htfab/flash-adc/verilog/gl/encoder.v

module encoder (VGND,
    VPWR,
    from_adc,
    ui_in,
    uio_in,
    uio_oe,
    uio_out,
    uo_out);
 input VGND;
 input VPWR;
 input [14:0] from_adc;
 input [7:0] ui_in;
 input [7:0] uio_in;
 output [7:0] uio_oe;
 output [7:0] uio_out;
 output [7:0] uo_out;

 wire _000_;
 wire _001_;
 wire _002_;
 wire _003_;
 wire _004_;
 wire _005_;
 wire _006_;
 wire _007_;
 wire _008_;
 wire _009_;
 wire _010_;
 wire _011_;
 wire _012_;
 wire _013_;
 wire _014_;
 wire _015_;
 wire _016_;
 wire _017_;
 wire _018_;
 wire _019_;
 wire _020_;
 wire _021_;
 wire _022_;
 wire _023_;
 wire _024_;
 wire _025_;
 wire _026_;
 wire _027_;
 wire _028_;
 wire _029_;
 wire _030_;
 wire _031_;
 wire _032_;
 wire _033_;
 wire _034_;
 wire _035_;
 wire _036_;
 wire _037_;
 wire _038_;
 wire _039_;
 wire _040_;
 wire _041_;
 wire _042_;
 wire _043_;
 wire _044_;
 wire _045_;
 wire _046_;
 wire _047_;
 wire _048_;
 wire _049_;
 wire _050_;
 wire _051_;
 wire _052_;
 wire _053_;
 wire _054_;
 wire _055_;
 wire _056_;
 wire _057_;
 wire _058_;
 wire _059_;
 wire _060_;
 wire _061_;
 wire _062_;
 wire _063_;
 wire _064_;
 wire \maj_level1[0] ;
 wire \maj_level1[1] ;
 wire \maj_level1[2] ;
 wire \maj_level1[3] ;
 wire \maj_level1[4] ;
 wire \maj_level1[5] ;
 wire \maj_level1[6] ;
 wire \maj_level2[0] ;
 wire \maj_level2[1] ;
 wire \maj_level2[2] ;
 wire maj_level3;
 wire net1;
 wire net10;
 wire net11;
 wire net12;
 wire net13;
 wire net14;
 wire net15;
 wire net16;
 wire net17;
 wire net18;
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
    .VGND(VGND),
    .VNB(VGND),
    .VPB(VPWR),
    .VPWR(VPWR),
    .X(\maj_level2[2] ));
 sky130_fd_sc_hd__maj3_4 mg30 (.A(\maj_level2[0] ),
    .B(\maj_level2[1] ),
    .C(\maj_level2[2] ),
    .VGND(VGND),
    .VNB(VGND),
    .VPB(VPWR),
    .VPWR(VPWR),
    .X(maj_level3));
endmodule
