htfab/flash-adc/(commit log)

2024-04-10 add project to version control
    [adc_with_encoder.sch, buffer.sch, comparator.sch, encoder_tree.sch, flash_adc.sch, ladder_rung.sch, opamp.sch, pin_order.cfg]
2024-04-17 replace encoder.mag with abstract view of gds
2024-04-17 work around magic pin extraction issue
